benhg/ammeter-clock/hardware/rev2/reports/netlist-check.txt

PASS: 32 components, 70 connected pins and 27 intentionally unused pins match schematic and PCB.
