benhg/ammeter-clock/Pcb-notes.txt

KN6UBF clock Rev F4: Pololu module, unchanged meter circuit values.
26 assembler placements: 6 SMT + 20 THT, all top; U4 is socket only.
R1 is 0805 22k 0.1%; C5 is 33uF/50V, D6.3mm, 2.5mm pitch.
C4 is 10uF/25V D5x11mm; buttons 5.5mm high; pull-ups 4.7k 1%.
Individual Samtec SSQ -03 headers have 10mm tails; target 12mm host-top to
shield-bottom separation, with actual insertion/USB/ESP fit checked physically.
Full fabrication: hardware/fabrication/ammeter-clock-rev-f4-fabrication.zip
Dated public JLC inventory is positive for all BOM entries; not reserved.
Customer buys Pololu U3V16F15, solders header to module, plugs into socket.
Pololu startup, real host fit and meter calibration remain prototype checks.
