benhg/ammeter-clock/hardware/rev2/reports/board-layout.png

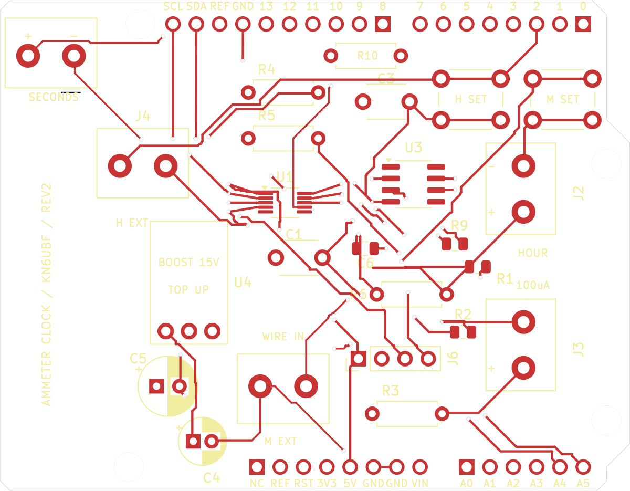
hardware/rev2/reports/board-layout.png
