benhg/ammeter-clock/hardware/rev2/bom.csv

Designators | Quantity | Unit | Value | Footprint | Manufacturer | MPN | Source | Assembly | Notes
J1 | 1 | piece | UNO_R3_POWER | AmmeterClock:Uno_R3_Stackable_1x08 | Samtec | SSQ-108-03-T-S | https://jlcpcb.com/partdetail/C3323936 | Assembler through-hole | Samtec SSQ -03; 10mm tails DOWN; target 12mm board gap, verify real fit; Same SSQ -03 stackable geometry: 8.51mm body,10mm square tails DOWN,2.54mm pitch,1.1mm drills. Tin contacts replace gold. At check 28 available; five boards need 10. Target12mm host-top/shield-bottom gap; verify real mating/clearance.
J7 | 1 | piece | UNO_R3_ANALOG | AmmeterClock:Uno_R3_Stackable_1x06 | Samtec | SSQ-106-03-G-S | https://jlcpcb.com/partdetail/C3323798 | Assembler through-hole | Samtec SSQ -03; 10mm tails DOWN; target 12mm board gap, verify real fit; Individual 6-pin single-row vertical strip; 2.54mm pitch, 8.51mm body, 10.00mm square tails DOWN. Retain 1.1mm plated holes. Rev F3 targets 12mm Uno-PCB-top to shield-PCB-bottom gap; verify actual socket engagement and clearance physically. Do not bottom pins against USB/ESP hardware. No SparkFun kit needed.
J8 | 1 | piece | UNO_R3_D0_D7 | AmmeterClock:Uno_R3_Stackable_1x08 | Samtec | SSQ-108-03-T-S | https://jlcpcb.com/partdetail/C3323936 | Assembler through-hole | Samtec SSQ -03; 10mm tails DOWN; target 12mm board gap, verify real fit; Same SSQ -03 stackable geometry: 8.51mm body,10mm square tails DOWN,2.54mm pitch,1.1mm drills. Tin contacts replace gold. At check 28 available; five boards need 10. Target12mm host-top/shield-bottom gap; verify real mating/clearance.
J9 | 1 | piece | UNO_R3_D8_SCL | AmmeterClock:Uno_R3_Stackable_1x10 | Samtec | SSQ-110-03-T-S | https://jlcpcb.com/partdetail/C3322872 | Assembler through-hole | Samtec SSQ -03; 10mm tails DOWN; target 12mm board gap, verify real fit; Individual 10-pin single-row vertical strip; 2.54mm pitch, 8.51mm body, 10.00mm square tails DOWN. Retain 1.1mm plated holes. Rev F3 targets 12mm Uno-PCB-top to shield-PCB-bottom gap; verify actual socket engagement and clearance physically. Do not bottom pins against USB/ESP hardware. No SparkFun kit needed.
U1 | 1 | piece | MCP4728-E/UN | Package_SO:MSOP-10_3x3mm_P0.5mm | Microchip | MCP4728-E/UN | https://jlcpcb.com/partdetail/MicrochipTech-MCP4728_EUN/C108207 | SMT | DAC D/pin9=hours, C/pin8=minutes, B/pin7=seconds; A/pin6 unused. Internal 2.048V reference, gain2, LDAC grounded.; MSOP-10, exact DAC family/package.
U3 | 1 | piece | OPA197ID | Package_SO:SOIC-8_3.9x4.9mm_P1.27mm | Texas Instruments | OPA197IDR | https://jlcpcb.com/partdetail/TexasInstruments-OPA197IDR/C79274 | SMT | ; SOIC-8. IDR tape/reel packaging equivalent to the designed OPA197ID tube part.
U4 | 1 | piece | 1x3 elevated female socket for customer Pololu module | AmmeterClock:Pololu_U3V16F15_Socket | Kinghelm | KH-2.54FH-1X3P-H8.5 | https://www.lcsc.com/product-detail/C2932670.html | Assembler through-hole | Assembler fits ONLY the 1x3 female socket, 2.54mm pitch, 8.5mm body height. Customer purchases and fits the Pololu U3V16F15 module; it is excluded from PCBA procurement and fitting.
R1 | 1 | piece | 22k 0.1% | Resistor_SMD:R_0805_2012Metric | RESI | PTFR0805B22K0N9 | https://jlcpcb.com/partdetail/C351592 | SMT | ; 22kohm +/-0.1%, 10ppm/C, 130mW, 0805. Rev F3 SMT footprint; nominal gain unchanged. At 12V hour output dissipates about 3.1mW.
R2 | 1 | piece | 10k 0.1% | Resistor_SMD:R_0805_2012Metric | RESI | PTFR0805B10K0N9 | https://jlcpcb.com/partdetail/C328436 | SMT | 10kohm+/-0.1%,10ppm/C,130mW,0805 SMT; gain unchanged. Dissipation at3.75Vfeedback approximately1.4mW. Replaces precision axial resistor; F4 local reroute.; 10kohm+/-0.1%,10ppm/C,130mW,0805 SMT; gain unchanged. Dissipation at3.75Vfeedback approximately1.4mW. Replaces precision axial resistor; F4 local reroute.
R3 | 1 | piece | 56k 1% | Resistor_THT:R_Axial_DIN0207_L6.3mm_D2.5mm_P7.62mm_Horizontal | Yageo | MFR50SFTE52-56K | https://www.lcsc.com/product-detail/C1373212.html | Assembler through-hole | Initial safe span; final value/dial requires calibration; 56k 1%; axial body 6.3x2.4mm; 7.62mm formed lead pitch.
R4 | 1 | piece | 4.7k | Resistor_THT:R_Axial_DIN0207_L6.3mm_D2.5mm_P7.62mm_Horizontal | YAGEO | MFR-25FTE52-4K7 | https://jlcpcb.com/partdetail/C173023 | Assembler through-hole | ; 4.7kohm +/-1%, 250mW, axial D2.4xL6.3mm, form to 7.62mm pitch. Same pull-up function and footprint.
R5 | 1 | piece | 4.7k | Resistor_THT:R_Axial_DIN0207_L6.3mm_D2.5mm_P7.62mm_Horizontal | YAGEO | MFR-25FTE52-4K7 | https://jlcpcb.com/partdetail/C173023 | Assembler through-hole | ; 4.7kohm +/-1%, 250mW, axial D2.4xL6.3mm, form to 7.62mm pitch. Same pull-up function and footprint.
C1 | 1 | piece | 100n | AmmeterClock:FH_CT4_0805_P5.08mm | FH (Guangdong Fenghua Advanced Tech) | CT4-0805B104K500F3 | https://jlcpcb.com/partdetail/C84772 | Assembler through-hole | 100nF50V X7R+/-10%,LEADED not SMT despite0805 in MPN.5.08mm leadpitch,max4.2x3.8x3.8mm body,0.50+/-0.10mm leads. Custom footprint1.0mm holes accommodates lead tolerances; nominal value unchanged.; 100nF50V X7R+/-10%,LEADED not SMT despite0805 in MPN.5.08mm leadpitch,max4.2x3.8x3.8mm body,0.50+/-0.10mm leads. Custom footprint1.0mm holes accommodates lead tolerances; nominal value unchanged.
C6 | 1 | piece | 1n C0G 25V | Capacitor_SMD:C_0805_2012Metric | Samsung Electro-Mechanics | CL21C102JBCNNNC | https://jlcpcb.com/partdetail/C1791 | SMT | 1nF50V C0G+/-5%,0805 SMT. Same feedback compensation value/dielectric/tolerance; F4 local reroute. Check JLC basic-part pricing in live quote.; 1nF50V C0G+/-5%,0805 SMT. Same feedback compensation value/dielectric/tolerance; F4 local reroute. Check JLC basic-part pricing in live quote.
R6 | 1 | piece | 47R 1% | Resistor_THT:R_Axial_DIN0207_L6.3mm_D2.5mm_P7.62mm_Horizontal | Yageo | MFR-25FTF52-47R | https://www.lcsc.com/product-detail/C1371928.html | Assembler through-hole | Output isolation; DC feedback senses meter side; 47 ohms 1%; axial body 6.3x2.4mm; 7.62mm formed lead pitch.
C3 | 1 | piece | 100n 25V | AmmeterClock:FH_CT4_0805_P5.08mm | FH (Guangdong Fenghua Advanced Tech) | CT4-0805B104K500F3 | https://jlcpcb.com/partdetail/C84772 | Assembler through-hole | 100nF50V X7R+/-10%,LEADED not SMT despite0805 in MPN.5.08mm leadpitch,max4.2x3.8x3.8mm body,0.50+/-0.10mm leads. Custom footprint1.0mm holes accommodates lead tolerances; nominal value unchanged.; 100nF50V X7R+/-10%,LEADED not SMT despite0805 in MPN.5.08mm leadpitch,max4.2x3.8x3.8mm body,0.50+/-0.10mm leads. Custom footprint1.0mm holes accommodates lead tolerances; nominal value unchanged.
C4 | 1 | piece | 10u 25V | Capacitor_THT:CP_Radial_D5.0mm_P2.00mm | Lelon | RXW100M1EBK-0511 | https://jlcpcb.com/partdetail/C231206 | Assembler through-hole | ; 10uF +/-20%, 25V, D5xL11mm, 2mm pitch, 105C rated. Same capacitance/rating/XY footprint; height increases to 11mm. Positive to pad 1.
C5 | 1 | piece | 33u 10V | Capacitor_THT:CP_Radial_D6.3mm_P2.50mm | Rubycon | 50YXM33MEFR6.3X11 | https://jlcpcb.com/partdetail/C432346 | Assembler through-hole | ; 33uF +/-20%, 50V, D6.3xL11mm, 2.5mm pitch. Rev F3 larger footprint and small position shift. Value remains 33uF on 5V rail; positive to pad 1.
J2 | 1 | piece | HOUR_0-15V | AmmeterClock:JILN_JL301_2P_P5.00mm | JILN | JL301-50002U02 | https://jlcpcb.com/partdetail/C395214 | Assembler through-hole | Two-position5.00mm-pitch screw terminal; body10x7.6x10.1mm,0.9mm leads,3.5mm tails. Custom footprint based on manufacturer drawing, wire entry toward +localY.15A/300V greatly exceeds meter/button loads. Blue housing.1.3mm drills.; Two-position5.00mm-pitch screw terminal; body10x7.6x10.1mm,0.9mm leads,3.5mm tails. Custom footprint based on manufacturer drawing, wire entry toward +localY.15A/300V greatly exceeds meter/button loads. Blue housing.1.3mm drills.
J3 | 1 | piece | MINUTE_100uA | AmmeterClock:JILN_JL301_2P_P5.00mm | JILN | JL301-50002U02 | https://jlcpcb.com/partdetail/C395214 | Assembler through-hole | Two-position5.00mm-pitch screw terminal; body10x7.6x10.1mm,0.9mm leads,3.5mm tails. Custom footprint based on manufacturer drawing, wire entry toward +localY.15A/300V greatly exceeds meter/button loads. Blue housing.1.3mm drills.; Two-position5.00mm-pitch screw terminal; body10x7.6x10.1mm,0.9mm leads,3.5mm tails. Custom footprint based on manufacturer drawing, wire entry toward +localY.15A/300V greatly exceeds meter/button loads. Blue housing.1.3mm drills.
J4 | 1 | piece | HOUR_EXT_BUTTON | AmmeterClock:JILN_JL301_2P_P5.00mm | JILN | JL301-50002U02 | https://jlcpcb.com/partdetail/C395214 | Assembler through-hole | Two-position5.00mm-pitch screw terminal; body10x7.6x10.1mm,0.9mm leads,3.5mm tails. Custom footprint based on manufacturer drawing, wire entry toward +localY.15A/300V greatly exceeds meter/button loads. Blue housing.1.3mm drills.; Two-position5.00mm-pitch screw terminal; body10x7.6x10.1mm,0.9mm leads,3.5mm tails. Custom footprint based on manufacturer drawing, wire entry toward +localY.15A/300V greatly exceeds meter/button loads. Blue housing.1.3mm drills.
J5 | 1 | piece | MIN_EXT_BUTTON | AmmeterClock:JILN_JL301_2P_P5.00mm | JILN | JL301-50002U02 | https://jlcpcb.com/partdetail/C395214 | Assembler through-hole | Two-position5.00mm-pitch screw terminal; body10x7.6x10.1mm,0.9mm leads,3.5mm tails. Custom footprint based on manufacturer drawing, wire entry toward +localY.15A/300V greatly exceeds meter/button loads. Blue housing.1.3mm drills. Rev2: rotated around body center so wire openings face the open center corridor, away from the power header; keep wiring corridor clear.; Two-position5.00mm-pitch screw terminal; body10x7.6x10.1mm,0.9mm leads,3.5mm tails. Custom footprint based on manufacturer drawing, wire entry toward +localY.15A/300V greatly exceeds meter/button loads. Blue housing.1.3mm drills.
SW1 | 1 | piece | HOUR_SET_NO | Button_Switch_THT:SW_PUSH_6mm | SOFNG | TS-1102-5516 | https://jlcpcb.com/partdetail/C183624 | Assembler through-hole | 6mm normally-open momentary tactile button; parallel with J4; 6x6mm normally-open switch; 6.5x4.5mm pin grid; top pair common and bottom pair common, matching PCB. 5.5mm actuator height replaces previous 13mm; 1.6N force. Still parallel to external screw terminals.
SW2 | 1 | piece | MIN_SET_NO | Button_Switch_THT:SW_PUSH_6mm | SOFNG | TS-1102-5516 | https://jlcpcb.com/partdetail/C183624 | Assembler through-hole | 6mm normally-open momentary tactile button; parallel with J5; 6x6mm normally-open switch; 6.5x4.5mm pin grid; top pair common and bottom pair common, matching PCB. 5.5mm actuator height replaces previous 13mm; 1.6N force. Still parallel to external screw terminals.
J6 | 1 | piece | RTC_I2C_OPTION | Connector_PinHeader_2.54mm:PinHeader_1x04_P2.54mm_Vertical | Connfly | DS1021-1x4SF11-B | https://www.lcsc.com/product-detail/C7430360.html | Assembler through-hole (RTC header) | Optional 5V-compatible RTC breakout; RTC firmware not yet implemented; Straight through-hole 1x4 male header, 2.54mm pitch. RTC header populated; external RTC module not supplied.
R9 | 1 | piece | 4.7k 1% | Resistor_SMD:R_0805_2012Metric | UNI-ROYAL | 0805W8F4701T5E | https://www.lcsc.com/product-detail/C17673.html | SMT | Series amplifier-input current limiting when 15V supply is absent/delayed; 4.7kohm +/-1%, 0805, 125mW. Series DAC-to-amplifier input protection; retain Pololu module.
R10 | 1 | piece | 56k 1% | Resistor_THT:R_Axial_DIN0207_L6.3mm_D2.5mm_P7.62mm_Horizontal | Yageo | MFR50SFTE52-56K | https://www.lcsc.com/product-detail/C1373212.html | Assembler through-hole | Seconds output; matches minute circuit. Initial safe span; final value/dial requires calibration; 56k 1%; axial body 6.3x2.4mm; 7.62mm formed lead pitch.
J10 | 1 | piece | SECOND_100uA | AmmeterClock:JILN_JL301_2P_P5.00mm | JILN | JL301-50002U02 | https://jlcpcb.com/partdetail/C395214 | Assembler through-hole | Seconds output; matches minute circuit. Two-position5.00mm-pitch screw terminal; body10x7.6x10.1mm,0.9mm leads,3.5mm tails. Custom footprint based on manufacturer drawing, wire entry toward +localY.15A/300V greatly exceeds meter/button loads. Blue housing.1.3mm drills.; Two-position5.00mm-pitch screw terminal; body10x7.6x10.1mm,0.9mm leads,3.5mm tails. Custom footprint based on manufacturer drawing, wire entry toward +localY.15A/300V greatly exceeds meter/button loads. Blue housing.1.3mm drills.
