benhg/ammeter-clock/tools/clock_setup/README.md

# KN6UBF Clock Setup — native desktop app 0.6.0

Qt Widgets application for Windows, macOS and Linux. There is no embedded browser,
localhost server, HTTP API or browser tab. USB and Arduino CLI operations run in a
background worker, with native controls for configuration and calibration.

## Customer flow

1. Plug the Uno into USB. Select its USB device in the **USB connection** panel.
   If clock firmware is already installed, click **Connect** immediately.
2. First-time setup or updating: use the separate **Install / update firmware** tab.
   Confirm the Arduino model, install firmware, then refresh USB devices and connect.
   The first install downloads Arduino board support. Close other serial applications.
3. In **Clock**, save a timezone and set computer time, or resume NTP on R4 WiFi.
4. In **Wi-Fi**, search nearby networks, select one or type a hidden network name.
   Search uses the R4 radio and requires firmware 0.4.0. Older firmware still accepts
   manually entered credentials. **Show password** reveals only the text currently
   entered; the stored password is never read back. Saving clears the password field
   and resumes NTP. Credentials are stored on the Arduino, not in the desktop app.
5. In **Calibration**, choose optional seconds, adjust mechanical zero at no output,
   then use lower/raise at a held 12:30 reference (12:30:30 with seconds). Verify fixed
   values or sweep, then Save. Drafts remain in RAM until Save; Cancel restores prior
   settings. Ten idle minutes hold outputs at zero. Closing normally cancels a wizard;
   unexpected disconnect uses the firmware timeout.

Both onboard and external buttons work on R3/R4. Hold both for three seconds on R4
to resume NTP after manual time adjustment. The RTC remains optional/not used.
Scanning may pause displayed needle updates/button processing while the WiFiS3
modem blocks; elapsed time is caught up afterward. No live board is flashed by builds.

## R4 Wi-Fi firmware update

In **Install / update firmware**, select a detected Uno R4 WiFi and click
**Update R4 Wi-Fi firmware**. This uses the bundled official Arduino Firmware
Uploader 2.4.1 to install qualified connectivity firmware **0.6.1**. It downloads
Arduino's firmware and supporting tools, so Internet access is required. The
version is deliberately pinned rather than silently selecting an untested release.

Wait for the update to finish, unplug **all** power for five seconds and reconnect.
Then click **I have reconnected — restore clock firmware**. Never upload the clock
sketch while the board is still in ESP download mode. The app matches the original
board's USB serial number (or its original port if no serial number was reported),
restores the bundled clock sketch and checks the Wi-Fi firmware version and any
previously readable calibration/timezone/output settings. Factory boards without
clock firmware can also be prepared. USB status does not return Wi-Fi passwords.

A local recovery record survives app restart and prevents the normal upload button
from bypassing the power-cycle step. If an update fails, reconnect and retry the
Wi-Fi update here; the original settings snapshot is retained. A failed verification
keeps the recovery record and its diagnostic log available. Finish with the
[pre-shipment checks](../../docs/PRE-SHIP-TEST.md), including cold-start NTP sync.

The firmware uploader is included on Windows, macOS and Linux with its vendor
license; its official release archive checksum is checked during packaging.

## Build and tests

```sh
python -m pip install -r tools/clock_setup/requirements.txt pyinstaller==6.22.0
python -m unittest discover -s tests -p 'test_*.py'
python tools/clock_setup/build_app.py
python tools/clock_setup/smoke_app.py
```

Use `QT_QPA_PLATFORM=offscreen` for headless native-widget tests. `native_app.py` is
the desktop entry point; `app.py` contains the USB/flasher backend. The optional
GitHub Pages Web Serial UI remains separate and is not bundled in the desktop app.
Qt (PySide6 Essentials) is LGPLv3; License texts and source links are bundled under `licenses/`. Source: https://doc.qt.io/qtforpython-6/licenses.html .

## macOS signing and notarization

Customer releases must use a **Developer ID Application** certificate with its
matching private key in the build machine's Keychain. An Apple Development
certificate does not qualify. Create the Developer ID certificate in Xcode or Apple's
developer portal. A certificate made from an externally generated CSR must be paired
with that CSR's private key and imported into Keychain before building.

Set up a notarization credential profile with Apple's `xcrun notarytool
store-credentials clock-notary` (interactive prompts; never commit secrets), then:

```sh
export MACOS_SIGNING_IDENTITY='Developer ID Application: Your Name (TEAMID)'
export MACOS_NOTARY_PROFILE=clock-notary
python tools/clock_setup/build_app.py
```

PyInstaller signs nested binaries and the bundle with hardened runtime. The build
verifies Developer ID signing, submits to Apple, requires Accepted, staples the
notarization ticket, validates it and runs Gatekeeper assessment before archiving.
Unsigned local development builds are allowed; they are not customer releases.

Tagged GitHub releases fail closed without signing secrets. Configure the six
repository secrets named in `configure_macos_ci.py`; it imports the .p12 into an
ephemeral runner keychain, configures notarization, and never prints key material or
passwords. Do not put .p12/private keys in this repository. Windows signing is not
configured; Windows reputation warnings are independent of Apple's notarization.

## Version 0.5.0

- The clock display ticks from a monotonic local timer every second between USB
  status updates, including while another USB operation is running. Status replies
  correct the display after time changes or reconnects.
- Connected Wi-Fi shows **Disconnect & search for networks** and an explanation.
  The firmware disconnects Wi-Fi, scans, then retries the saved network; USB remains
  open. Older firmware offers **Update firmware & search**, then automatically
  reconnects USB and scans. The user confirms the firmware replacement first.
- **Resume Wi-Fi / NTP** is disabled when Wi-Fi is connected and NTP is active,
  but available when a manual time adjustment has paused automatic synchronization.
- All 598 zones/aliases in pinned IANA tzdata 2026.6 are searchable. **Custom UTC
  offset** reveals editable minute-offset and legacy DST controls. Named zones
  upload UTC offset transitions to two CRC-protected EEPROM banks, preserving the
  previous zone if an update is interrupted. The generated schedule covers at least
  ten future years (up to the firmware's 2100 limit). Refresh a named zone after
  timezone-law changes or when the app reports an expired schedule. The board does
  not need a connected computer to apply saved transitions. Existing calibration,
  Wi-Fi settings and legacy custom offsets retain their original EEPROM layout.
- **Sweep duration** controls both wizard and saved-calibration sweeps, 5–600
  seconds, including endpoints. Defaults remain 61 seconds. An active sweep does
  not consume the wizard's idle timeout; the timeout restarts after it finishes.

The included firmware is 0.5.0. Named-zone saving, variable calibration and scanning
provide combined update/reconnect actions when the attached clock needs an update.
Custom offset saving continues to work with older firmware without upgrading.
