benhg/ammeter-clock/tools/clock_setup/index.html

KN6UBF / ANALOG CLOCK

# A little time to set things up.

Flash your Uno, set the time, and give your clock a network to call home.

Connect your clock with a USB data cable.

↓

## Get the desktop app

Download, extract, and open KN6UBF Clock Setup. It opens this setup interface in your browser and handles firmware flashing locally. Python and Arduino CLI are included; board support downloads on the first flash.

Windows · 64-bit (https://github.com/benhg/ammeter-clock/releases/latest/download/clock-setup-Windows-x64.zip)Mac · Apple silicon (https://github.com/benhg/ammeter-clock/releases/latest/download/clock-setup-macOS-arm64.zip)Mac · Intel (https://github.com/benhg/ammeter-clock/releases/latest/download/clock-setup-macOS-x64.zip)Linux · 64-bit (https://github.com/benhg/ammeter-clock/releases/latest/download/clock-setup-Linux-x64.tar.gz)

The first builds are unsigned; macOS apps are not notarized. Linux needs a desktop browser and USB serial permissions. Release notes and checksums (https://github.com/benhg/ammeter-clock/releases/latest)

01

## Connect & update

USB deviceRefresh

Arduino model

ConnectDisconnectFlash firmware

Flashing replaces the sketch. Saved clock settings are retained when compatible. Reconnect afterward. Outputs start disabled on a new installation.

Firmware upload log

No upload yet.

02

## Time & timezone

— : — : —Not connected

Timezone

Standard UTC offset (minutes)Daylight saving

Use computer timeSave timezoneResume NTP

Both boards: press HOUR or MINUTE once to advance; hold to repeat. Buttons reset seconds. On R4 WiFi, manual setting pauses NTP until restart or Resume NTP. Hold both buttons together for three seconds to resume Wi-Fi/NTP sync without changing settings. Without NTP or an RTC, set time again after power loss or reset.

03

## Wi-Fi R4 WiFi

Wi-Fi settings are available after connecting an R4 WiFi.

Network name (SSID)Password This network has no password

Save Wi-FiForget network

Use a 2.4 GHz network. Credentials are sent over USB and stored on the Arduino; they are never saved by this tool. NTP syncs at startup and hourly while connected.

04

## Meter calibration

Match the needles to known reference marks with a guided calibration. The clock keeps time in the background; only Save changes your calibration.

I have a seconds meter connected (Rev 2) Start calibration wizard

Connect the clock to begin.

↓ Lower needle↑ Raise needle

Adjustment size

Calculate from the current needle reading

Needle currently readsMatch reference

Hold a few different values and check that all needles line up. These are test values; they do not change the clock's time.

HourMinuteSecond

Hold test valuesRun sweepStop sweep

BackNeedle is correct · NextSave & run clockCancel · discard changes

Cancel restores the previous calibration and output setting. An inactive wizard times out after ten minutes and holds outputs at zero until you start again or enable the meters.

Advanced calibration values and output controls

Hours use a 0–15 V voltmeter. Minutes require a 0–100 µA movement and a calibrated 0–60 dial. The present board supplies about 73 µA maximum. Enable only after wiring and calibration have been checked.

Hour code at 12Minute code at 60

Save calibration I have checked meter polarity, ratings, and calibration.

Enable metersDisable meters

Output state unknown.

Run test patternStop test

With meters enabled, sweep hours 0–12 and minutes 0–60 over 61 seconds, then return to the current time. Calibration and saved time are unchanged. Either physical button also stops the test.

USB clock setup · firmware 0.3.0 · no account required Quit setup app
