benhg/ammeter-clock/hardware/rev2/reports/firmware-r4wifi-build.txt

Sketch uses 83236 bytes (31%) of program storage space. Maximum is 262144 bytes.
Global variables use 12348 bytes (37%) of dynamic memory, leaving 20420 bytes for local variables. Maximum is 32768 bytes.
