benhg/ammeter-clock/hardware/rev2/simulations/results/ripple_summary 2.csv

rail | frequency_Hz | assumed_supply_ripple_pp_V | output_ripple_pp_V
usb | 100 | 0.1 | 0.0003390000000003113
boost | 100 | 0.1 | 2.1999999990640617e-06
boost | 100000 | 0.1 | 0.0009186700000000103
boost | 1200000 | 0.1 | 0.005595245999999943
