benhg/ammeter-clock/hardware/rev2/simulations/results/hour_corners.csv

usb_V | boost_V | meter_ohm | gain_corner | output_V | error_vs_12_V | boost_current_mA
4.5 | 14.4 | 1000 | -1 | 11.9835583 | -0.01644169999999967 | 13.3581864
4.5 | 14.4 | 1000 | 0 | 12.0000419 | 4.1899999999372994e-05 | 13.375044500000001
4.5 | 14.4 | 1000 | 1 | 12.0165514 | 0.016551400000000882 | 13.3919294
4.5 | 14.4 | 2000 | -1 | 11.9835638 | -0.016436199999999346 | 7.36640834
4.5 | 14.4 | 2000 | 0 | 12.0000474 | 4.7399999999697684e-05 | 7.37502474
4.5 | 14.4 | 2000 | 1 | 12.0165639 | 0.01656389999999952 | 7.38365839
4.5 | 14.4 | 10000 | -1 | 11.9835745 | -0.016425500000000426 | 2.5729848300000002
4.5 | 14.4 | 10000 | 0 | 12.000058 | 5.799999999922534e-05 | 2.5750078100000002
4.5 | 14.4 | 10000 | 1 | 12.0165746 | 0.016574600000000217 | 2.57703484
4.5 | 14.4 | 100000 | -1 | 11.983576 | -0.01642400000000066 | 1.4944630700000001
4.5 | 14.4 | 100000 | 0 | 12.0000597 | 5.969999999955178e-05 | 1.49500241
4.5 | 14.4 | 100000 | 1 | 12.0165763 | 0.016576300000000543 | 1.49554306
4.5 | 15 | 1000 | -1 | 11.9835591 | -0.016440899999999203 | 13.358187299999999
4.5 | 15 | 1000 | 0 | 12.0000358 | 3.5799999999142074e-05 | 13.375036999999999
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
