benhg/ammeter-clock/hardware/rev2/simulations/results/minute_corners 3.csv

usb_V | series_ohm | coil_ohm | assumed_DAC_output_ohm | current_uA
4.5 | 55440 | 0 | 0 | 73.86363639999999
4.5 | 55440 | 0 | 20 | 73.8369996
4.5 | 55440 | 1000 | 0 | 72.5549256
4.5 | 55440 | 1000 | 20 | 72.5292242
4.5 | 55440 | 10000 | 0 | 62.576405900000005
4.5 | 55440 | 10000 | 20 | 62.5572869
4.5 | 56000 | 0 | 0 | 73.125
4.5 | 56000 | 0 | 20 | 73.0988933
4.5 | 56000 | 1000 | 0 | 71.8421053
4.5 | 56000 | 1000 | 20 | 71.8169063
4.5 | 56000 | 10000 | 0 | 62.045454500000005
4.5 | 56000 | 10000 | 20 | 62.0266586
4.5 | 56560 | 0 | 0 | 72.4009901
4.5 | 56560 | 0 | 20 | 72.37539770000001
4.5 | 56560 | 1000 | 0 | 71.143155
4.5 | 56560 | 1000 | 20 | 71.1184439
4.5 | 56560 | 10000 | 0 | 61.5234375
4.5 | 56560 | 10000 | 20 | 61.5049564
4.7 | 55440 | 0 | 0 | 73.86363639999999
4.7 | 55440 | 0 | 20 | 73.8369996
4.7 | 55440 | 1000 | 0 | 72.5549256
4.7 | 55440 | 1000 | 20 | 72.5292242
4.7 | 55440 | 10000 | 0 | 62.576405900000005
4.7 | 55440 | 10000 | 20 | 62.5572869
4.7 | 56000 | 0 | 0 | 73.125
4.7 | 56000 | 0 | 20 | 73.0988933
4.7 | 56000 | 1000 | 0 | 71.8421053
4.7 | 56000 | 1000 | 20 | 71.8169063
4.7 | 56000 | 10000 | 0 | 62.045454500000005
4.7 | 56000 | 10000 | 20 | 62.0266586
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
