benhg/ammeter-clock/hardware/rev2/simulations/results/seconds_corners.csv

series_ohm | coil_ohm | output_ohm | minute_uA | second_uA
55440 | 0 | 0 | 73.86363639999999 | 73.86363639999999
55440 | 0 | 20 | 73.8369996 | 73.8369996
55440 | 1000 | 0 | 72.5549256 | 72.5549256
55440 | 1000 | 20 | 72.5292242 | 72.5292242
55440 | 10000 | 0 | 62.576405900000005 | 62.576405900000005
55440 | 10000 | 20 | 62.5572869 | 62.5572869
56000 | 0 | 0 | 73.125 | 73.125
56000 | 0 | 20 | 73.0988933 | 73.0988933
56000 | 1000 | 0 | 71.8421053 | 71.8421053
56000 | 1000 | 20 | 71.8169063 | 71.8169063
56000 | 10000 | 0 | 62.045454500000005 | 62.045454500000005
56000 | 10000 | 20 | 62.0266586 | 62.0266586
56560 | 0 | 0 | 72.4009901 | 72.4009901
56560 | 0 | 20 | 72.37539770000001 | 72.37539770000001
56560 | 1000 | 0 | 71.143155 | 71.143155
56560 | 1000 | 20 | 71.1184439 | 71.1184439
56560 | 10000 | 0 | 61.5234375 | 61.5234375
56560 | 10000 | 20 | 61.5049564 | 61.5049564
