benhg/ammeter-clock/hardware/rev2/ammeter-clock/ammeter-clock.kicad_pcb

## KiCad design hardware/rev2/ammeter-clock/ammeter-clock.kicad_pcb (2026-11-10)

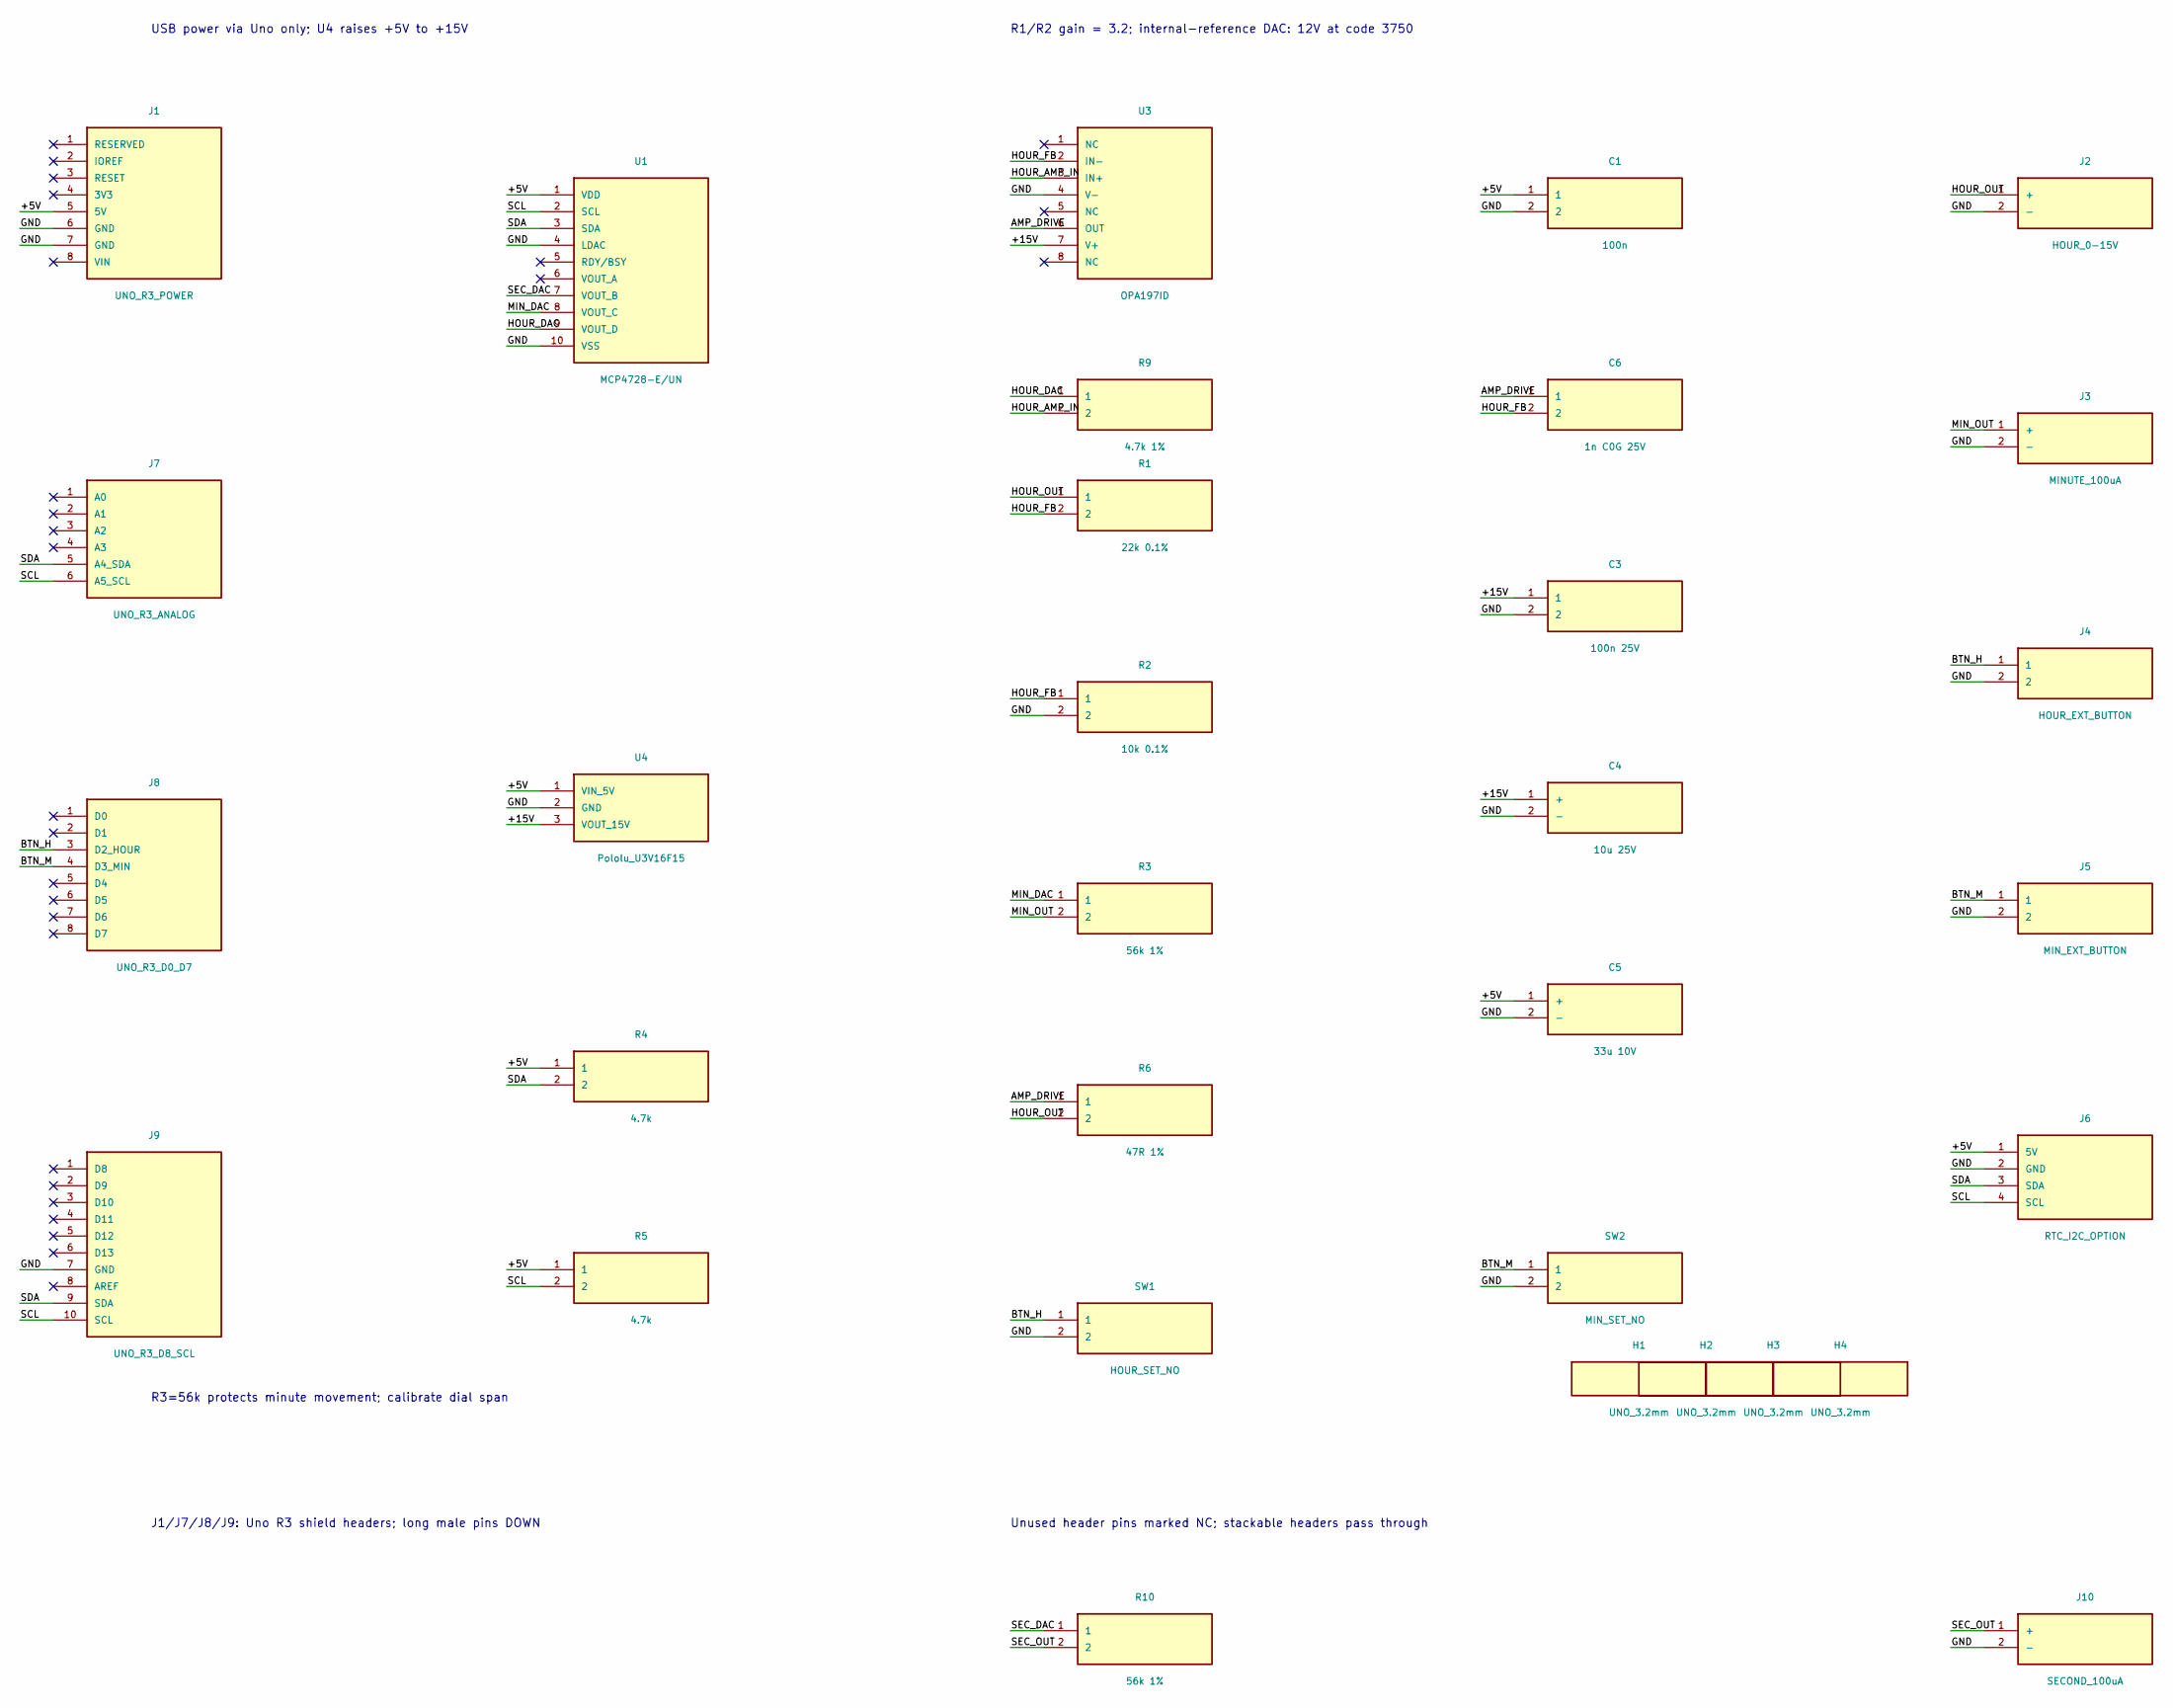
[picture p2: schematic ammeter-clock.kicad_sch, USB-powered analog clock shield]

Parts:
C1: 100n; FH_CT4_0805_P5.08mm
C3: 100n 25V; FH_CT4_0805_P5.08mm
C4: 10u 25V; CP_Radial_D5.0mm_P2.00mm
C5: 33u 10V; CP_Radial_D6.3mm_P2.50mm
C6: 1n C0G 25V; C_0805_2012Metric
H1, H2, H3, H4: UNO_3.2mm; Uno_MountHole_3.2mm
J1: UNO_R3_POWER; Uno_R3_Stackable_1x08
J2: HOUR_0-15V; JILN_JL301_2P_P5.00mm
J3: MINUTE_100uA; JILN_JL301_2P_P5.00mm
J4: HOUR_EXT_BUTTON; JILN_JL301_2P_P5.00mm
J5: MIN_EXT_BUTTON; JILN_JL301_2P_P5.00mm
J6: RTC_I2C_OPTION; PinHeader_1x04_P2.54mm_Vertical
J7: UNO_R3_ANALOG; Uno_R3_Stackable_1x06
J8: UNO_R3_D0_D7; Uno_R3_Stackable_1x08
J9: UNO_R3_D8_SCL; Uno_R3_Stackable_1x10
J10: SECOND_100uA; JILN_JL301_2P_P5.00mm
R1: 22k 0.1%; R_0805_2012Metric
R2: 10k 0.1%; R_0805_2012Metric
R3, R10: 56k 1%; R_Axial_DIN0207_L6.3mm_D2.5mm_P7.62mm_Horizontal
R4, R5: 4.7k; R_Axial_DIN0207_L6.3mm_D2.5mm_P7.62mm_Horizontal
R6: 47R 1%; R_Axial_DIN0207_L6.3mm_D2.5mm_P7.62mm_Horizontal
R9: 4.7k 1%; R_0805_2012Metric
SW1: HOUR_SET_NO; SW_PUSH_6mm
SW2: MIN_SET_NO; SW_PUSH_6mm
U1: MCP4728-E/UN; MSOP-10_3x3mm_P0.5mm
U3: OPA197ID; SOIC-8_3.9x4.9mm_P1.27mm
U4: Pololu_U3V16F15; Pololu_U3V16F15_Socket

Connections:
/+5V: C1.1, C5.1 (+), J1.5 (5V), J6.1 (5V), R4.1, R5.1, U1.1 (VDD), U4.1 (VIN_5V)
/+15V: C3.1, C4.1 (+), U3.7 (V+), U4.3 (VOUT_15V)
/AMP_DRIVE: C6.1, R6.1, U3.6 (OUT)
/BTN_H: J4.1, J8.3 (D2_HOUR), SW1.1
/BTN_M: J5.1, J8.4 (D3_MIN), SW2.1
/GND: C1.2, C3.2, C4.2 (-), C5.2 (-), J1.6 (GND), J1.7 (GND), J2.2 (-), J3.2 (-), J4.2, J5.2, J6.2 (GND), J9.7 (GND), J10.2 (-), R2.2, SW1.2, SW2.2, U1.4 (LDAC), U1.10 (VSS), U3.4 (V-), U4.2 (GND)
/HOUR_AMP_IN: R9.2, U3.3 (IN+)
/HOUR_DAC: R9.1, U1.9 (VOUT_D)
/HOUR_FB: C6.2, R1.2, R2.1, U3.2 (IN-)
/HOUR_OUT: J2.1 (+), R1.1, R6.2
/MIN_DAC: R3.1, U1.8 (VOUT_C)
/MIN_OUT: J3.1 (+), R3.2
/SCL: J6.4 (SCL), J7.6 (A5_SCL), J9.10 (SCL), R5.2, U1.2 (SCL)
/SDA: J6.3 (SDA), J7.5 (A4_SDA), J9.9 (SDA), R4.2, U1.3 (SDA)
/SEC_DAC: R10.1, U1.7 (VOUT_B)
/SEC_OUT: J10.1 (+), R10.2

Notes on the sheet:
USB power via Uno only; U4 raises +5V to +15V
R1/R2 gain = 3.2; internal-reference DAC: 12V at code 3750
R3=56k protects minute movement; calibrate dial span
J1/J7/J8/J9: Uno R3 shield headers; long male pins DOWN
Unused header pins marked NC; stackable headers pass through

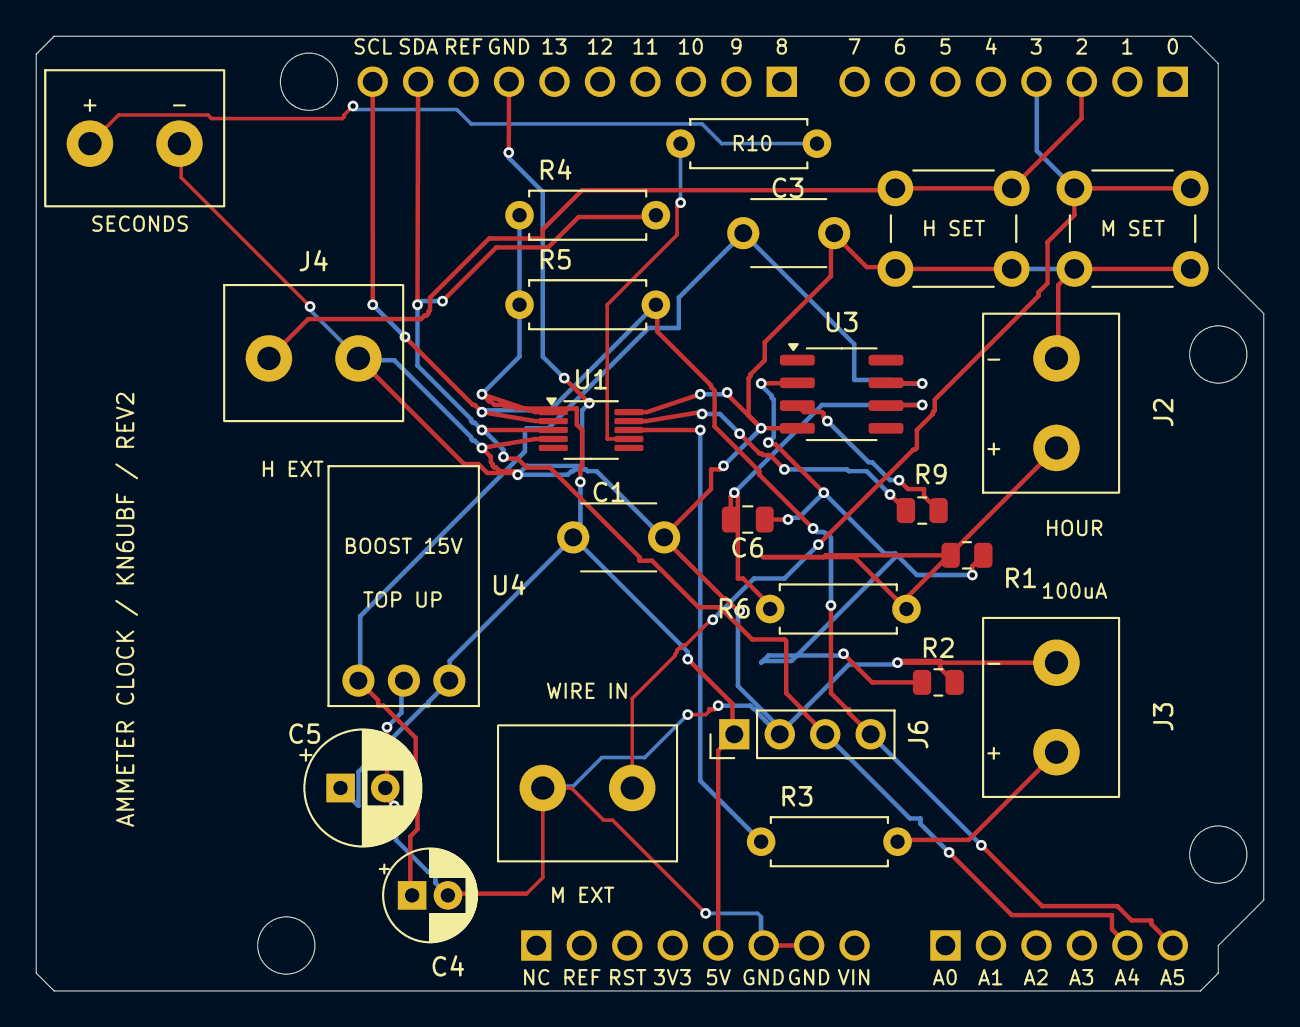
[picture p3: board ammeter-clock.kicad_pcb from above]

Board: 2 copper layers, 68.6 x 53.3 mm, 32 parts (0 on the bottom side), 16 nets.
