benhg/ammeter-clock/firmware/AmmeterClock/AmmeterClock.ino

#include <Arduino.h>
#include <Wire.h>
#include <EEPROM.h>
#include <stdlib.h>
#include "ClockCore.h"
#include "TimeZoneStore.h"
#if defined(ARDUINO_UNOR4_WIFI)
#include <WiFiS3.h>
#include <WiFiUdp.h>
#define CLOCK_WIFI 1
#else
#define CLOCK_WIFI 0
#endif
using namespace ClockCore;
constexpr uint8_t DAC_ADDRESS = 0x60;
Settings settings;
Button hourButton, minuteButton;
bool dacReady = false, timeValid = false, manualOverride = false;
bool testActive = false;
uint8_t testStep = 0;
uint32_t testStarted = 0,testDurationMs=61000;
bool calActive=false,calExpired=false,calSeconds=false;
uint16_t calHourScale=0,calMinuteScale=0,calSecondScale=0;
uint8_t calHour=0,calMinute=0,calSecond=0;
uint32_t calTouched=0;
bool chordTracking=false,chordFired=false,pendingHour=false,pendingMinute=false;
uint32_t chordStarted=0,hourPendingAt=0,minutePendingAt=0;
uint32_t utcEpoch = MIN_EPOCH, lastTick = 0;
const char *timeSource = "unset";
char inputLine[224];
uint16_t inputLength = 0;
bool inputOverflow = false;
#if CLOCK_WIFI
WiFiUDP udp;
IPAddress ntpAddress;
bool udpReady = false, ntpWaiting = false, ntpDue = true;
uint32_t lastNetwork = 0, lastAttempt = 0, ntpSentAt = 0;
uint32_t lastNtpAttempt = 0, ntpInterval = 60000;
uint8_t ntpCookie[8];
int wifiState = WL_IDLE_STATUS;
const char *ntpState = "waiting_wifi";
uint32_t ntpPackets = 0;
int ntpLastSize = 0;
uint8_t ntpChecks = 0;
#endif

bool writeDAC(uint8_t channel, uint16_t code) {
  if (code > 4095) code = 4095;
  Wire.beginTransmission(DAC_ADDRESS);
  Wire.write(uint8_t(0x40 | ((channel & 3) << 1)));
  Wire.write(uint8_t(0x90 | ((code >> 8) & 0x0F)));
  Wire.write(uint8_t(code));
  return Wire.endTransmission() == 0;
}
void zeroOutputs() {
  bool ok = true;
  for (uint8_t c = 0; c < 4; ++c) if (!writeDAC(c,0)) ok = false;
  dacReady = ok;
}
uint32_t clockLocalEpoch(uint32_t epoch){
 if(TimeZoneStore::covers(epoch))return epoch+int32_t(TimeZoneStore::offset(epoch))*60;
 return localEpoch(epoch,settings);
}
void updateGauges() {
  if (!dacReady) return;
  uint32_t local = clockLocalEpoch(utcEpoch);
  uint8_t hour = (local / 3600) % 12;
  if (!hour) hour = 12;
  bool drive=settings.enabled&&timeValid&&!calExpired;
  uint16_t hs=calActive?calHourScale:settings.hourScale;
  uint16_t ms=calActive?calMinuteScale:settings.minuteScale;
  uint16_t ss=calActive?calSecondScale:settings.secondScale;
  bool seconds=calActive?calSeconds:settings.secondsEnabled;
  uint16_t h=drive?uint32_t(hour)*hs/12:0;
  uint16_t m=drive?uint32_t(local/60%60)*ms/60:0;
  uint16_t second=drive&&seconds?uint32_t(local%60)*ss/60:0;
  if(calActive){h=uint32_t(calHour)*hs/12;m=uint32_t(calMinute)*ms/60;second=seconds?uint32_t(calSecond)*ss/60:0;}
  if(testActive){h=uint32_t(testStep/5)*hs/12;m=uint32_t(testStep)*ms/60;second=seconds?uint32_t(testStep)*ss/60:0;}
  bool hOK=writeDAC(HOUR_CHANNEL,h),mOK=writeDAC(MINUTE_CHANNEL,m),sOK=writeDAC(SECOND_CHANNEL,second);
  if(!hOK||!mOK||!sOK){calActive=false;testActive=false;zeroOutputs();dacReady=false;}
}
void cancelCalibration(){calActive=false;calExpired=false;testActive=false;updateGauges();}

void testTick(uint32_t now) {
  if (!testActive) return;
  uint32_t elapsed=uint32_t(now-testStarted);
  uint32_t step=elapsed*61UL/testDurationMs;
  if (elapsed>=testDurationMs) { testActive = false;if(calActive)calTouched=now;updateGauges(); }
  else if (step != testStep) { testStep = step; updateGauges(); }
}
void saveSettings() {
  settings.checksum = checksum(settings);
  // Invalidate before update; publish the magic only after the payload is stored.
  for (uint8_t i = 0; i < 4; ++i) EEPROM.update(i,0);
  const uint8_t *p = reinterpret_cast<const uint8_t*>(&settings);
  for (size_t i = 4; i < sizeof(settings); ++i) EEPROM.update(i,p[i]);
  for (uint8_t i = 0; i < 4; ++i) EEPROM.update(i,p[i]);
}
void setClock(uint32_t epoch, const char *source) {
  utcEpoch = epoch; lastTick = millis(); timeValid = true; timeSource = source;
  updateGauges();
}
void ok() { Serial.println(F("OK {}")); }
void error(const __FlashStringHelper *message) { Serial.print(F("ERR ")); Serial.println(message); }
void printStatus() {
  Serial.print(F("OK {\"protocol\":1,\"firmware\":\"0.5.0\",\"board\":\""));
#if CLOCK_WIFI
  Serial.print(F("uno-r4-wifi"));
#else
  Serial.print(F("uno-r3"));
#endif
  Serial.print(F("\",\"epoch\":")); Serial.print(utcEpoch);
  Serial.print(F(",\"local_epoch\":")); Serial.print(clockLocalEpoch(utcEpoch));
  Serial.print(F(",\"time_valid\":")); Serial.print(timeValid ? F("true") : F("false"));
  Serial.print(F(",\"source\":\"")); Serial.print(timeSource);
  Serial.print(F("\",\"manual_override\":")); Serial.print(manualOverride ? F("true") : F("false"));
  Serial.print(F(",\"dac_ready\":")); Serial.print(dacReady ? F("true") : F("false"));
  Serial.print(F(",\"enabled\":")); Serial.print(settings.enabled ? F("true") : F("false"));
  Serial.print(F(",\"test_active\":")); Serial.print(testActive ? F("true") : F("false"));
  Serial.print(F(",\"test_hour\":")); Serial.print(testActive ? testStep/5 : 0);
  Serial.print(F(",\"test_minute\":")); Serial.print(testActive ? testStep : 0);
  Serial.print(F(",\"cal_active\":"));Serial.print(calActive?F("true"):F("false"));
  Serial.print(F(",\"cal_timeout\":"));Serial.print(calExpired?F("true"):F("false"));
  Serial.print(F(",\"seconds_enabled\":"));Serial.print(settings.secondsEnabled?F("true"):F("false"));
  Serial.print(F(",\"second_scale\":"));Serial.print(settings.secondScale);
  if(calActive){
    Serial.print(F(",\"draft_hour\":"));Serial.print(calHourScale);
    Serial.print(F(",\"draft_minute\":"));Serial.print(calMinuteScale);
    Serial.print(F(",\"draft_second\":"));Serial.print(calSecondScale);
    Serial.print(F(",\"draft_seconds_enabled\":"));Serial.print(calSeconds?F("true"):F("false"));
    Serial.print(F(",\"cal_hour\":"));Serial.print(calHour);
    Serial.print(F(",\"cal_minute\":"));Serial.print(calMinute);
    Serial.print(F(",\"cal_second\":"));Serial.print(calSecond);
  }
  Serial.print(F(",\"hour_scale\":")); Serial.print(settings.hourScale);
  Serial.print(F(",\"minute_scale\":")); Serial.print(settings.minuteScale);
  Serial.print(F(",\"offset\":")); Serial.print(settings.offsetMinutes);
  Serial.print(F(",\"dst\":")); Serial.print(settings.dst);
  Serial.print(F(",\"test_duration_supported\":true,\"timezone_supported\":true,\"timezone_name\":\""));Serial.print(TimeZoneStore::active>=0?TimeZoneStore::current.name:"");
  Serial.print(F("\",\"timezone_stale\":"));Serial.print(TimeZoneStore::active>=0&&!TimeZoneStore::covers(utcEpoch)?F("true"):F("false"));
  Serial.print(F(",\"wifi_scan_disconnect_supported\":"));Serial.print(CLOCK_WIFI?F("true"):F("false"));
  Serial.print(F(",\"wifi_scan_supported\":")); Serial.print(CLOCK_WIFI ? F("true") : F("false"));
  Serial.print(F(",\"wifi_supported\":")); Serial.print(CLOCK_WIFI ? F("true") : F("false"));
  Serial.print(F(",\"wifi_configured\":")); Serial.print(settings.ssid[0] ? F("true") : F("false"));
  Serial.print(F(",\"wifi_connected\":"));
#if CLOCK_WIFI
  Serial.print(wifiState == WL_CONNECTED ? F("true") : F("false"));
#else
  Serial.print(F("false"));
#endif
#if CLOCK_WIFI
  Serial.print(F(",\"wifi_firmware\":\"")); Serial.print(WiFi.firmwareVersion());
  Serial.print(F("\",\"wifi_ip\":\"")); Serial.print(WiFi.localIP());
  Serial.print(F("\",\"wifi_code\":")); Serial.print(wifiState);
  Serial.print(F(",\"ntp_state\":\"")); Serial.print(ntpState);
  Serial.print(F("\",\"ntp_packets\":")); Serial.print(ntpPackets);
  Serial.print(F(",\"ntp_size\":")); Serial.print(ntpLastSize);
  Serial.print(F(",\"ntp_checks\":")); Serial.print(ntpChecks);
#endif
  Serial.println(F("}"));
}
bool number(const char *s, long minimum, long maximum, long &out) {
  if (!s || !*s) return false;
  char *end; out = strtol(s,&end,10);
  return !*end && out >= minimum && out <= maximum;
}
void calibrationCommand(char *context){
  char *op=strtok_r(nullptr," ",&context);
  char *a=strtok_r(nullptr," ",&context),*b=strtok_r(nullptr," ",&context),*c=strtok_r(nullptr," ",&context),*extra=strtok_r(nullptr," ",&context);
  long x,y,z;
  if(!op||extra){error(F("invalid_calibration_command"));return;}
  if(!strcmp(op,"BEGIN")&&!b&&number(a,0,1,x)){
    if(!dacReady){error(F("dac_unavailable"));return;}
    if(calActive){error(F("calibration_already_active"));return;}
    calHourScale=settings.hourScale;calMinuteScale=settings.minuteScale;calSecondScale=settings.secondScale;
    calSeconds=x;calHour=calMinute=calSecond=0;calExpired=false;testActive=false;calActive=true;calTouched=millis();
#if CLOCK_WIFI
    ntpWaiting=false;ntpDue=true;
#endif
    updateGauges();ok();return;
  }
  if(!strcmp(op,"CANCEL")&&!a){cancelCalibration();ok();return;}
  if(!calActive){error(F("calibration_not_active"));return;}
  if(!strcmp(op,"TARGET")&&number(a,0,12,x)&&number(b,0,60,y)&&number(c,0,60,z)){
    calHour=x;calMinute=y;calSecond=z;testActive=false;
  }else if(!strcmp(op,"SCALE")&&number(a,1,4095,x)&&number(b,1,4095,y)&&number(c,1,4095,z)){
    calHourScale=x;calMinuteScale=y;calSecondScale=z;
  }else if(!strcmp(op,"SWEEP")&&!b&&(!a||number(a,5,600,x))){testDurationMs=(a?x:61)*1000UL;testActive=true;testStep=0;testStarted=millis();
  }else if(!strcmp(op,"SAVE")&&!a){
    if(!dacReady){error(F("dac_unavailable"));return;}
    settings.hourScale=calHourScale;settings.minuteScale=calMinuteScale;settings.secondScale=calSecondScale;
    settings.secondsEnabled=calSeconds;settings.enabled=true;calActive=false;calExpired=false;testActive=false;saveSettings();
  }else{error(F("invalid_calibration_command"));return;}
  calTouched=millis();updateGauges();ok();
}
void timezoneCommand(char* context){
 char*op=strtok_r(nullptr," ",&context);char*a=strtok_r(nullptr," ",&context);char*b=strtok_r(nullptr," ",&context);char*c=strtok_r(nullptr," ",&context);char*d=strtok_r(nullptr," ",&context);char*extra=strtok_r(nullptr," ",&context);
 if(!op||extra){error(F("invalid_timezone_command"));return;}
 if(!strcmp(op,"CANCEL")&&!a){TimeZoneStore::pending=-1;ok();return;}
 if(!strcmp(op,"BEGIN")&&a&&b&&c&&d){
  char name[64]={};char*e1;char*e2;char*e3;unsigned long from=strtoul(b,&e1,10),until=strtoul(c,&e2,10);long off=strtol(d,&e3,10);
  if(from<MAX_EPOCH&&until<=MAX_EPOCH&&!*e1&&!*e2&&!*e3&&b[0]!='-'&&c[0]!='-'&&off>=-720&&off<=840&&decodeHex(a,name,sizeof(name))&&TimeZoneStore::begin(name,from,until,off)){ok();return;}
 }else if(!strcmp(op,"ADD")&&a&&b&&!c){
  char*e1;char*e2;unsigned long epoch=strtoul(a,&e1,10);long off=strtol(b,&e2,10);
  if(epoch<MAX_EPOCH&&!*e1&&!*e2&&a[0]!='-'&&off>=-720&&off<=840&&TimeZoneStore::add(epoch,off)){ok();return;}
 }else if(!strcmp(op,"SAVE")&&!a&&TimeZoneStore::commit()){
  settings.offsetMinutes=TimeZoneStore::offset(utcEpoch);settings.dst=0;saveSettings();updateGauges();ok();return;
 }
 error(F("invalid_timezone_command"));
}
void command(char *line) {
  char *context;
  char *cmd = strtok_r(line," ",&context);
  if(cmd&&!strcmp(cmd,"TZ")){timezoneCommand(context);return;}
  if(cmd&&!strcmp(cmd,"CAL")){calibrationCommand(context);return;}
  char *a = strtok_r(nullptr," ",&context);
  char *b = strtok_r(nullptr," ",&context);
  char *extra = strtok_r(nullptr," ",&context);
  if (!cmd) return;
  long x,y;
  if (!strcmp(cmd,"STATUS") && !a) { printStatus(); return; }
  if (!strcmp(cmd,"TIME") && a && !b) {
    char *end; unsigned long epoch = strtoul(a,&end,10);
    if (*end || a[0] == '-' || epoch < MIN_EPOCH || epoch >= MAX_EPOCH) { error(F("time_range")); return; }
    manualOverride = true; setClock(epoch,"usb"); ok(); return;
  }
  if (!strcmp(cmd,"ZONE") && !extra && number(a,-720,840,x) && number(b,0,2,y)) {
    TimeZoneStore::clear();settings.offsetMinutes = x; settings.dst = y; saveSettings(); updateGauges(); ok(); return;
  }
  if (!strcmp(cmd,"SCALE") && !extra && number(a,1,4095,x) && number(b,1,4095,y)) {
    if(calActive){error(F("finish_calibration_first"));return;}
    testActive = false; settings.hourScale = x; settings.minuteScale = y; saveSettings(); updateGauges(); ok(); return;
  }
  if (!strcmp(cmd,"OUTPUT") && !b && number(a,0,1,x)) {
    if (x && !dacReady) { error(F("dac_unavailable")); return; }
    if (x && !timeValid) { error(F("set_time_first")); return; }
    if (!x){calActive=false;testActive=false;}
    calExpired=false;
    settings.enabled = x; saveSettings(); updateGauges(); ok(); return;
  }
  if(!strcmp(cmd,"SECONDS")&&!b&&number(a,0,1,x)){
    if(calActive){error(F("finish_calibration_first"));return;}
    settings.secondsEnabled=x;saveSettings();updateGauges();ok();return;
  }
  if (!strcmp(cmd,"TEST") && a && !extra) {
    if (!strcmp(a,"STOP")&&!b) { testActive = false; updateGauges(); ok(); return; }
    if (!strcmp(a,"START")) {
      if(b&&!number(b,5,600,x)){error(F("test_duration_range"));return;}
      testDurationMs=(b?x:61)*1000UL;
      if(calActive){error(F("use_calibration_sweep"));return;}
      if (!dacReady) { error(F("dac_unavailable")); return; }
      if (!settings.enabled) { error(F("enable_meters_first")); return; }
#if CLOCK_WIFI
      ntpWaiting = false; ntpDue = true; // do not accept an old reply after the sweep
#endif
      testActive = true; testStep = 0; testStarted = millis(); updateGauges(); ok(); return;
    }
  }
  if (!strcmp(cmd,"WIFI_SCAN") && !a) {
#if CLOCK_WIFI
    if(calActive||testActive){error(F("finish_meter_test_first"));return;}
    udp.stop();udpReady=false;ntpWaiting=false;ntpDue=true;
    WiFi.disconnect();wifiState=WL_IDLE_STATUS;lastAttempt=millis()-60000UL;
    int count=WiFi.scanNetworks();
    if(count<0){error(F("wifi_scan_failed"));return;}
    Serial.print(F("OK {\"networks\":["));
    for(int i=0;i<count&&i<32;++i){
      if(i)Serial.print(F(","));
      Serial.print(F("{\"ssid_hex\":\""));
      const char* ssid=WiFi.SSID(i);
      for(uint8_t j=0;ssid&&ssid[j]&&j<32;++j){
        const char* hex="0123456789abcdef";uint8_t c=uint8_t(ssid[j]);
        Serial.print(hex[c>>4]);Serial.print(hex[c&15]);
      }
      Serial.print(F("\",\"rssi\":"));Serial.print(WiFi.RSSI(i));
      Serial.print(F(",\"open\":"));Serial.print(WiFi.encryptionType(i)==ENC_TYPE_NONE?F("true"):F("false"));
      Serial.print(F("}"));
    }
    Serial.println(F("]}"));
#else
    error(F("wifi_not_supported"));
#endif
    return;
  }
  if (!strcmp(cmd,"WIFI") && a && b && !extra) {
#if CLOCK_WIFI
    char ssid[33] = {}, password[65] = {};
    if (!decodeHex(a,ssid,sizeof(ssid)) || !ssid[0] || !decodeHex(b,password,sizeof(password))
        || (strlen(password) && strlen(password) < 8)) { error(F("wifi_credentials")); return; }
    memcpy(settings.ssid,ssid,sizeof(ssid)); memcpy(settings.password,password,sizeof(password));
    saveSettings(); udp.stop(); udpReady = false; ntpWaiting = false;
    WiFi.disconnect(); wifiState = WL_IDLE_STATUS; lastAttempt = millis()-60000UL; ntpDue = true;
    ok(); return;
#else
    error(F("wifi_not_supported")); return;
#endif
  }
  if (!strcmp(cmd,"WIFI_CLEAR") && !a) {
    memset(settings.ssid,0,sizeof(settings.ssid)); memset(settings.password,0,sizeof(settings.password)); saveSettings();
#if CLOCK_WIFI
    udp.stop(); WiFi.disconnect(); udpReady = false; ntpWaiting = false; wifiState = WL_IDLE_STATUS;
#endif
    ok(); return;
  }
  if (!strcmp(cmd,"SYNC") && !a) {
#if CLOCK_WIFI
    manualOverride = false; ntpWaiting = false; ntpDue = true; ok(); return;
#else
    error(F("wifi_not_supported")); return;
#endif
  }
  error(F("invalid_command"));
}
void readCommands() {
  // Bounded work per loop keeps buttons responsive under serial noise.
  for (uint8_t count = 0; count < 64 && Serial.available(); ++count) {
    char c = Serial.read();
    if (c == '\r') continue;
    if (c == '\n') {
      if (inputOverflow) error(F("line_too_long"));
      else { inputLine[inputLength] = 0; command(inputLine); }
      memset(inputLine,0,sizeof(inputLine)); inputLength = 0; inputOverflow = false;
    } else if (c < 32 || inputLength >= sizeof(inputLine)-1) inputOverflow = true;
    else inputLine[inputLength++] = c;
  }
}
#if CLOCK_WIFI
void networkTick(uint32_t now) {
  if (!settings.ssid[0] || uint32_t(now-lastNetwork) < 250) return;
  lastNetwork = now;
  wifiState = WiFi.status();
  if (wifiState != WL_CONNECTED) {
    if (udpReady) { udp.stop(); udpReady = false; ntpWaiting = false; }
    if (uint32_t(now-lastAttempt) >= 60000) {
      lastAttempt = now;
      // Library calls are synchronous; cap association wait to one second.
      WiFi.setTimeout(1000);
      wifiState = settings.password[0] ? WiFi.begin(settings.ssid,settings.password) : WiFi.begin(settings.ssid);
      ntpDue = true; ntpState = "connecting";
    }
    return;
  }
  if (!udpReady) { udpReady = udp.begin(2390); if (!udpReady) { ntpState = "udp_failed"; return; } ntpDue = true; }
  if (manualOverride) { ntpState = "paused"; return; }
  int length = udp.parsePacket();
  if (length) {
    uint8_t packet[48];
    int read = udp.read(packet,sizeof(packet));
    ++ntpPackets; ntpLastSize = read;
    ntpChecks = (udp.remotePort() == 123 ? 1 : 0) | (udp.remoteIP() == ntpAddress ? 2 : 0)
      | (read == 48 && !memcmp(packet+24,ntpCookie,8) ? 4 : 0);
    ntpState = "rejected_reply";
    uint32_t epoch;
    if (ntpWaiting && length >= 48 && read == 48 && udp.remotePort() == 123
        && udp.remoteIP() == ntpAddress && ntpReply(packet,sizeof(packet),ntpCookie,epoch)) {
      setClock(epoch,"ntp"); ntpWaiting = false; ntpInterval = 3600000UL; ntpState = "synced";
    }
  }
  if (ntpWaiting && uint32_t(now-ntpSentAt) >= 5000) { ntpWaiting = false; ntpState = "reply_timeout"; }
  if (!ntpWaiting && (ntpDue || uint32_t(now-lastNtpAttempt) >= ntpInterval)) {
    ntpDue = false; lastNtpAttempt = now; ntpInterval = 5000;
    // Cloudflare anycast address keeps time sync independent of DNS.
    // https://developers.cloudflare.com/time-services/ntp/usage/
    ntpAddress = IPAddress(162,159,200,1);
    ntpState = "begin_packet_failed";
    uint8_t packet[48] = {};
    packet[0] = 0x23; // NTP v4 client, synchronized-state unknown.
    for (uint8_t i = 0; i < 8; ++i) ntpCookie[i] = uint8_t(random(1,256));
    memcpy(packet+40,ntpCookie,8);
    if (udp.beginPacket(ntpAddress,123)) {
      ntpState = "write_failed";
      if (udp.write(packet,sizeof(packet)) == sizeof(packet)) {
        ntpState = "end_packet_failed";
        if (udp.endPacket()) { ntpWaiting = true; ntpSentAt = millis(); ntpInterval = 60000; ntpState = "awaiting_reply"; }
      }
    }
  }
}
#endif
void setup() {
  Serial.begin(115200); pinMode(2,INPUT_PULLUP); pinMode(3,INPUT_PULLUP); Wire.begin();
  EEPROM.get(0,settings);if(!valid(settings)){SettingsV1 old;EEPROM.get(0,old);if(!migrate(old,settings))settings=defaults();}
  TimeZoneStore::load();
  zeroOutputs(); lastTick = millis(); updateGauges();
#if CLOCK_WIFI
  randomSeed(micros()); lastAttempt = millis()-60000UL;
#endif
}
void loop() {
  uint32_t now = millis();
  testTick(now);
  uint32_t elapsed = uint32_t(now-lastTick)/1000;
  if (elapsed) { utcEpoch += elapsed; lastTick += elapsed*1000; updateGauges(); }
  readCommands();
  now = millis();
  if(calActive&&!testActive&&uint32_t(now-calTouched)>=600000UL){calActive=false;testActive=false;calExpired=true;updateGauges();}
  bool h=hourButton.poll(digitalRead(2)==LOW,now),m=minuteButton.poll(digitalRead(3)==LOW,now);
  bool both=digitalRead(2)==LOW&&digitalRead(3)==LOW;
  if(both){
    pendingHour=pendingMinute=false;
    if(!chordTracking){chordTracking=true;chordFired=false;chordStarted=now;}
    if(!chordFired&&uint32_t(now-chordStarted)>=3000){
      chordFired=true;cancelCalibration();
#if CLOCK_WIFI
      manualOverride=false;ntpWaiting=false;ntpDue=true;
#endif
    }
  }else if(chordTracking){
    pendingHour=pendingMinute=false;
    if(digitalRead(2)==HIGH&&digitalRead(3)==HIGH){chordTracking=false;chordFired=false;}
  }else{
    if(h&&!pendingHour){pendingHour=true;hourPendingAt=now;}
    if(m&&!pendingMinute){pendingMinute=true;minutePendingAt=now;}
    h=pendingHour&&uint32_t(now-hourPendingAt)>=180;
    m=pendingMinute&&uint32_t(now-minutePendingAt)>=180;
    if(h||m){
      if(h)pendingHour=false;if(m)pendingMinute=false;
      cancelCalibration();
      if(!timeValid){utcEpoch=MIN_EPOCH-int32_t(settings.offsetMinutes)*60;timeValid=true;}
      utcEpoch-=clockLocalEpoch(utcEpoch)%60;
      if(h)utcEpoch+=3600;if(m)utcEpoch+=60;manualOverride=true;
#if CLOCK_WIFI
      ntpWaiting=false;
#endif
      lastTick=now;timeSource="buttons";updateGauges();
    }
  }
#if CLOCK_WIFI
  if (!testActive&&!calActive&&!chordTracking) networkTick(millis());
#endif
}
