benhg/ammeter-clock/tests/firmware_test.cpp

#include <cassert>
#include <iostream>
#include "Arduino.h"
#include "Wire.h"
#include "EEPROM.h"
uint32_t fakeNow = 0;
int pins[4] = {HIGH,HIGH,HIGH,HIGH};
SerialMock Serial;
WireMock Wire;
EEPROMMock EEPROM;
#include "../firmware/AmmeterClock/AmmeterClock.ino"
void send(const std::string &s) {
  Serial.output.clear(); Serial.input = s+"\n";
  while (Serial.available()) readCommands();
}
int main() {
  setup(); assert(dacReady && !settings.enabled && !timeValid);
  for (int i=0;i<4;++i) assert(Wire.writes[i][1] == 0x40+i*2);
  send("OUTPUT 1"); assert(Serial.output == "ERR set_time_first\n");
  send("ZONE -480 1"); assert(settings.offsetMinutes == -480 && settings.dst == 1);
  send("TIME 1793215800"); assert(timeValid && manualOverride);
  send("STATUS"); assert(Serial.output.find("\"manual_override\":true")!=std::string::npos);
  send("SCALE 3750 4095"); send("OUTPUT 1"); assert(settings.enabled);
  // 2026-01-01 20:30 UTC = 12:30 Pacific standard time.
  setClock(dateEpoch(2026,1,1)+20*3600+30*60,"usb");
  auto packet = [](uint8_t c,uint16_t code){return std::vector<uint8_t>{0x60,uint8_t(0x40|(c<<1)),uint8_t(0x90|(code>>8)),uint8_t(code)};};
  assert(Wire.writes[Wire.writes.size()-3] == packet(3,3750));
  assert(Wire.writes[Wire.writes.size()-2] == packet(2,2047));
  // Both dial endpoints, automatic return, no writes, stop/disable cancellation.
  unsigned patternWrites=EEPROM.writes;
  uint32_t before=utcEpoch;
  send("TEST START"); assert(testActive && testStep==0);
  assert(Wire.writes[Wire.writes.size()-3]==packet(3,0) && Wire.writes[Wire.writes.size()-2]==packet(2,0));
  fakeNow+=30000; loop(); assert(testActive && testStep==30 && utcEpoch==before+30);
  assert(Wire.writes[Wire.writes.size()-3]==packet(3,1875) && Wire.writes[Wire.writes.size()-2]==packet(2,2047));
  fakeNow+=30000; loop(); assert(testActive && testStep==60);
  assert(Wire.writes[Wire.writes.size()-3]==packet(3,3750) && Wire.writes[Wire.writes.size()-2]==packet(2,4095));
  fakeNow+=1000; loop(); assert(!testActive && utcEpoch==before+61);
  assert(EEPROM.writes==patternWrites);
  send("TEST START"); send("TEST STOP"); assert(!testActive);
  send("TEST START"); send("OUTPUT 0"); assert(!testActive && !settings.enabled);
  send("TEST START"); assert(!testActive && Serial.output=="ERR enable_meters_first\n");
  send("OUTPUT 1");
  // Test timer survives millis rollover.
  fakeNow=UINT32_MAX-499; lastTick=fakeNow; send("TEST START");
  fakeNow=500; loop(); assert(testActive && testStep==1);
  send("TEST STOP");
  // Reset reference for the existing clock/button checks below.
  fakeNow=0; setClock(dateEpoch(2026,1,1)+20*3600+30*60,"usb");
  unsigned writes = EEPROM.writes;
  fakeNow += 61000; loop(); assert(utcEpoch == dateEpoch(2026,1,1)+20*3600+31*60+1);
  assert(EEPROM.writes == writes); // no flash wear from clock ticks
  // Bounce rejected, initial press accepted, hold repeat and release.
  send("TEST START");
  pins[2]=LOW; loop(); fakeNow+=10; loop(); assert(!hourButton.stable);
  fakeNow+=21; loop(); assert(hourButton.stable && testActive);
  fakeNow+=180; loop(); assert(!testActive && !strcmp(timeSource,"buttons"));
  uint32_t t=utcEpoch;
  fakeNow+=620;loop(); // repeat event is queued after 800ms held
  fakeNow+=180;loop(); assert(utcEpoch==t+3600);
  pins[2]=HIGH;loop();fakeNow+=31;loop();assert(!hourButton.stable);
  // A two-button hold cancels both pending clicks and preserves time/settings.
  pins[2]=pins[3]=LOW;loop();t=utcEpoch;
  fakeNow+=31;loop();fakeNow+=3000;loop();assert(chordFired&&utcEpoch==t+3);
  pins[2]=pins[3]=HIGH;loop();fakeNow+=31;loop();assert(!chordTracking);
  // Rollover preserves fractional seconds.
  lastTick=UINT32_MAX-499; fakeNow=500; t=utcEpoch; loop(); assert(utcEpoch==t+1);
  // Invalid input cannot silently change saved settings.
  send("SCALE 4096 20"); assert(settings.hourScale==3750 && Serial.output.find("ERR ")==0);
  send("TIME 42949672960"); assert(Serial.output.find("ERR ")==0);
  send("ZONE -900 0"); assert(settings.offsetMinutes==-480);
  send("TIME 1793215800 extra"); assert(Serial.output.find("ERR ")==0);
  send("SYNC"); assert(Serial.output=="ERR wifi_not_supported\n");
  send(std::string(300,'X')); assert(Serial.output=="ERR line_too_long\n");
  send("STATUS"); assert(Serial.output.find("OK {")==0);
  // Migrate installed v1 data without losing per-unit calibration or credentials.
  SettingsV1 legacy={};legacy.magic=0x434C4B32UL;legacy.version=1;legacy.offsetMinutes=-480;
  legacy.dst=1;legacy.hourScale=3719;legacy.minuteScale=3413;legacy.enabled=1;
  strcpy(legacy.ssid,"example");strcpy(legacy.password,"test-password");legacy.checksum=checksum(legacy);
  Settings migrated;assert(migrate(legacy,migrated)&&valid(migrated));
  assert(migrated.hourScale==3719&&migrated.minuteScale==3413&&!migrated.secondsEnabled);
  assert(!strcmp(migrated.password,legacy.password));
  // Wizard drafts are volatile, zero is exact, arbitrary reference holds are independent of time.
  send("SECONDS 1");assert(settings.secondsEnabled);
  unsigned wizardWrites=EEPROM.writes;
  Settings original=settings;
  send("CAL BEGIN 1");assert(calActive);
  assert(Wire.writes[Wire.writes.size()-3]==packet(3,0));
  assert(Wire.writes[Wire.writes.size()-2]==packet(2,0)&&Wire.writes.back()==packet(1,0));
  send("CAL TARGET 12 30 30");assert(calHour==12&&calMinute==30&&calSecond==30);
  send("CAL SCALE 3719 3413 3400");assert(calHourScale==3719&&settings.hourScale==original.hourScale);
  uint32_t held=utcEpoch;fakeNow+=3000;loop();assert(utcEpoch==held+3);
  assert(Wire.writes[Wire.writes.size()-3]==packet(3,3719));
  assert(Wire.writes[Wire.writes.size()-2]==packet(2,1706)&&Wire.writes.back()==packet(1,1700));
  send("CAL SWEEP");fakeNow+=60000;loop();assert(testActive&&testStep==60);
  assert(Wire.writes.back()==packet(1,3400));
  fakeNow+=1000;loop();assert(!testActive&&calActive&&Wire.writes.back()==packet(1,1700));
  assert(EEPROM.writes==wizardWrites);
  send("CAL CANCEL");assert(!calActive&&!memcmp(&settings,&original,sizeof(Settings)));
  send("CAL BEGIN 1");send("CAL TARGET 6 15 45");send("CAL SCALE 3719 3413 3400");send("CAL SAVE");
  assert(!calActive&&settings.hourScale==3719&&settings.minuteScale==3413&&settings.secondScale==3400);
  Settings committed;EEPROM.get(0,committed);assert(valid(committed));
  send("CAL BEGIN 0");fakeNow+=600001;loop();assert(!calActive&&calExpired&&Wire.writes.back()==packet(1,0));
  send("CAL CANCEL");assert(!calExpired);
  send("CAL BEGIN 0");send("OUTPUT 0");assert(!calActive&&!settings.enabled);
  send("CAL SAVE");assert(Serial.output=="ERR calibration_not_active\n");
  // Variable durations preserve all endpoints and do not time out an active wizard.
  send("CAL BEGIN 1");send("CAL TARGET 6 15 45");send("CAL SWEEP 5");
  fakeNow+=2500;loop();assert(testActive&&testStep==30);
  fakeNow+=2499;loop();assert(testActive&&testStep==60);
  fakeNow+=1;loop();assert(!testActive&&calActive&&calHour==6);
  send("CAL SWEEP 600");fakeNow+=599999;loop();assert(calActive&&testActive&&testStep==60);
  fakeNow+=1;loop();assert(calActive&&!testActive&&!calExpired);
  send("CAL CANCEL");send("OUTPUT 1");send("TEST START 120");fakeNow+=60000;loop();assert(testActive&&testStep==30);
  fakeNow+=60000;loop();assert(!testActive);send("TEST START 4");assert(Serial.output=="ERR test_duration_range\n");
  // A delayed loop must not keep postponing a queued repeat forever.
  hourButton=Button();minuteButton=Button();pendingHour=pendingMinute=false;
  pins[2]=pins[3]=HIGH;loop();pins[2]=LOW;fakeNow+=40;loop();fakeNow+=40;loop();
  fakeNow+=180;loop();
  auto slowEpoch=utcEpoch;
  fakeNow+=800;loop();fakeNow+=200;loop();
  assert(utcEpoch>=slowEpoch+3600);
  pins[2]=HIGH;loop();fakeNow+=40;loop();
  // Persisted config survives reload, corrupt or incomplete writes are rejected.
  Settings saved; EEPROM.get(0,saved); assert(valid(saved));
  saved.password[0]='X'; assert(!valid(saved));
  EEPROM.data[0]=0; EEPROM.get(0,saved); assert(!valid(saved));
  // Failed writes latch outputs off, including future updates.
  testActive=true; Wire.failingAddress=DAC_ADDRESS; updateGauges(); assert(!dacReady && !testActive);
  size_t n=Wire.writes.size(); updateGauges(); assert(Wire.writes.size()==n);
  // US DST exact transition boundaries (Pacific).
  Settings s=defaults(); s.offsetMinutes=-480; s.dst=1;
  uint32_t spring=dateEpoch(2026,3,8)+10*3600;
  assert(!summerTime(spring-1,s) && summerTime(spring,s));
  uint32_t fall=dateEpoch(2026,11,1)+9*3600;
  assert(summerTime(fall-1,s) && !summerTime(fall,s));
  s.offsetMinutes=60;s.dst=2;
  assert(!summerTime(dateEpoch(2026,3,29)+3599,s));
  assert(summerTime(dateEpoch(2026,3,29)+3600,s));
  assert(!summerTime(dateEpoch(2026,10,25)+3600,s));
  assert(yearOf(dateEpoch(2099,12,31))==2099);
  uint8_t reply[48] = {}, cookie[8] = {1,2,3,4,5,6,7,8};
  reply[0]=0x24; reply[1]=2; memcpy(reply+24,cookie,8);
  uint32_t expected=dateEpoch(2040,1,1), ntp=expected+2208988800UL, received=0;
  for(int i=0;i<4;++i) reply[40+i]=uint8_t(ntp>>(24-8*i));
  assert(ntpReply(reply,48,cookie,received) && received==expected);
  reply[24]^=1; assert(!ntpReply(reply,48,cookie,received)); reply[24]^=1;
  reply[0]=0xe4; assert(!ntpReply(reply,48,cookie,received)); reply[0]=0x24;
  reply[1]=0; assert(!ntpReply(reply,48,cookie,received)); reply[1]=2;
  assert(!ntpReply(reply,0,cookie,received));
  char text[8];assert(decodeHex("41422043",text,sizeof(text)) && !strcmp(text,"AB C"));
  assert(!decodeHex("00",text,sizeof(text)) && !decodeHex("gg",text,sizeof(text)));
  assert(!decodeHex("4142434445464748",text,sizeof(text)));
  std::cout << "PASS: firmware commands, DAC mapping, timing, buttons, persistence, rollover, DST, and faults\n";
}
