benhg/ammeter-clock/(commit log)

2026-11-10 Add Rev 2 seconds output, guided calibration and button NTP sync
2026-11-11 Resume notarization safely after Keychain locks or network interruptions
